zlosynth/kaseta/hack/release.tmpl.md

## Changes

${CHANGES}

## Firmware

Kaseta's firmware can be upgraded to obtain new features and bug-fixes. To do so, download the binary from attachments bellow, navigate to [Electro-Smith's web programmer](https://flash.daisy.audio/) and follow the guide to upload the binary through the "File Upload" tab.
