zlosynth/kaseta/(threads)

Thread 2 (2023-10-07):

Hardware final?

KeLaiFu, 2023-10-07:
I'm considering getting a few daisy boards and found your 2 projects, which both look great. Could you confirm if the hardware is finalized (for kaseta and achordian) before I throw my money at thonk?

Awesome looking modules and thanks for sharing them 👍👍👍

phoracek, 2023-10-07:
Hey! I'm happy you like my modules. I consider hardware of both of them done. I don't plan any changes to their schema or layout at the moment. If there ever would be any modifications to them, they would be backwards compatible.

KeLaiFu, 2023-10-09:
thanks for the reply, that's great news. I will get the iron warmed up!

Closed 2023-10-09.
