zlosynth/kaseta/(commit log)

2022-08-07 Fix import in oversampling doctest
    [mod.rs]
2022-08-12 Reduce oversampling to 4x
    With the current (lack of) optimization, my laptop cannot keep up with
    8x oversampling.
    This patch reduces oversampling in expense of aliasing.
2022-08-22 Fix the direction of delay
    [mod.rs]
2022-09-11 Adapt wow to inverted buffers
    [mod.rs]
2022-09-11 Switch upsampling to kaseta buffer
2022-09-11 Switch downsampling to kaseta buffer
2022-09-11 Fix ring buffer peeking
    [mod.rs]
2022-09-12 Fix linter after oversampling optimization
    [mod.rs]
2022-09-12 Remove signal binding from oversampling
    [mod.rs]
2022-10-01 Keep Wow attributes in its own struct
    Avoid accessing attributes of nested primitives.
    [mod.rs]
2022-10-01 Expose wow amplitude spring
2022-10-01 Cover wow module with prop tests
2022-10-01 Use a custom state variable filter
2022-10-01 Control filtering of wow amplitude
2022-10-01 Generalize wow filter for the whole wave
2022-10-01 Assure that filter does not put wow beyond limits
2022-10-03 Document danger zone switch
2022-10-04 Initialize kicad project
    [Module.kicad_pcb, Module.kicad_sch]
2022-10-04 Design basic interface panel outline
    [Module.kicad_pcb, Module.kicad_sch]
2022-10-14 Remove dedicated head switches from control
2022-10-15 Allow switching of delay range
2022-10-15 Rearange jacks on the PCB
    This way it should fit Daisy.
    [Module.kicad_pcb, Module.kicad_sch]
2022-10-17 Implement basic rewind feature
    Scrolling to the past acts as 1 octave down pitch shift.
2022-10-28 Add impulse LED to the PCB
    [Module.kicad_pcb, Module.kicad_sch]
2022-10-28 Align jacks, delay and big pots
    [Module.kicad_pcb, Module.kicad_sch]
2022-10-28 Place pot labels and fix their order
    [Module.kicad_pcb]
2022-10-28 Align sliders and rest of the pots
    [Module.kicad_pcb]
2022-10-28 Align LEDs on PCB and add labels
    [Module.kicad_pcb]
2022-10-28 Show Daisy labels on the correct side of board
    [Module.kicad_pcb]
2022-10-29 Align button and its LED
    [Module.kicad_pcb]
2022-10-29 All labels to peripherals
    [Module.kicad_pcb, Module.kicad_sch]
2022-10-29 Position DIP switch socket
    [Module.kicad_pcb]
2022-10-29 Add labels to peripherals in schematic
    [Module.kicad_sch]
2022-10-29 Set PCB and schematic title
    [Module.kicad_pcb, Module.kicad_sch]
2022-10-30 Add release script
    [Module.kicad_pcb]
2022-10-30 Release version 0.1.0
    [Module.kicad_pcb, Module.kicad_sch]
2022-10-30 Release version 0.2.0
    [Module.kicad_pcb, Module.kicad_sch]
2022-11-06 Control wow using a single attribute
    With this patch, most of the wow input attributes were replaced by hardcoded
    values. The only attribute that can be controlled is wow's depth.
    [mod.rs]
2022-11-06 Release versoin 0.3.0
    [Module.kicad_pcb, Module.kicad_sch]
2022-11-07 Align bottom-most pot with the a jack in Achordion
    [Module.kicad_pcb]
2022-11-07 Align PCB with panel design
    [Module.kicad_pcb]
2022-11-07 Add I2C connection to the schematic
    [Module.kicad_pcb, Module.kicad_sch]
2022-11-07 Add power to the schematic
    [Module.kicad_pcb, Module.kicad_sch]
2022-11-07 Add LEDs to the schematic
    [Module.kicad_pcb, Module.kicad_sch]
2022-11-07 Add power to the MCU in schematics
    [Module.kicad_sch]
2022-11-07 Connect jacks in the schematics
    [Module.kicad_pcb, Module.kicad_sch]
2022-11-07 Add pots to the schematic
    [Module.kicad_sch]
2022-11-07 Add multiplexers into the schematic
    [Module.kicad_pcb, Module.kicad_sch]
2022-11-07 Use pull-down resistors for muxed DIP
    [Module.kicad_sch]
2022-11-07 Temporary mapping of I/O in schematics
    [Module.kicad_pcb, Module.kicad_sch]
2022-11-08 Add holes under jack sockets in PCB
    [Module.kicad_pcb]
2022-11-08 Rely on the on-board power filters and protection
    Daisy patch SM has backward power protection installed and all
    the other components on board are using only power provided from Daisy.
    [Module.kicad_pcb, Module.kicad_sch]
2022-11-08 Wire up the bottom half of the PCB
    [Module.kicad_pcb, Module.kicad_sch]
2022-11-08 Wire up everything except for LEDs
    [Module.kicad_pcb, Module.kicad_sch]
2022-11-09 Wire up the rest of the board
    And also add some silk screen goodies.
    [Module.kicad_pcb, Module.kicad_sch]
2022-11-09 Select JLCPCB parts for BOM
    [Module.kicad_pcb]
2022-11-09 Add a note about JLC PCB tools
2022-11-09 Fix power on DIP switch
    It should be 3.3 V, otherwise it would burn Daisy.
    [Module.kicad_pcb, Module.kicad_sch]
2022-11-09 Prepare for gerber generating
    [Module.kicad_pcb, Module.kicad_sch]
2022-11-12 Install rust arm toolchain
2022-11-12 Blink status LED
2022-11-12 Introduce board abstraction with GPIO bindings
    [button.rs, debounced.rs, mod.rs, multiplexer.rs]
2022-11-12 Bind CV peripherals to the board abstraction
2022-11-12 Implement binding for pot peripherals
    [button.rs, mod.rs, pots.rs]
2022-11-13 Implement input probe
    Probes will detect whether there is anything connected to CV inputs.
2022-11-13 Fix wrongly positioned daisy footprint
    [Module.kicad_pcb, Module.kicad_sch]
2022-11-14 Remap firmware pins based on the PCB rework
    [button.rs, cvs.rs, multiplexer.rs, pots.rs]
2022-11-14 Implement LEDs access interface
2022-11-17 Implement calibration calculator
2022-11-17 Implement calibration state machine
2022-11-18 Utilize calibration on control inputs
2022-11-18 Implement impulse led output
2022-11-18 Test led and trigger impulse outputs
2022-11-26 Adjust trimmer footprints
    Holder leg holes in the regular ones are too small to fit.
    [Module.kicad_pcb, Module.kicad_sch]
2022-11-26 Rotate trim pots upright
    [Module.kicad_pcb, Module.kicad_sch]
2022-11-26 Get rid of unnecessary vias
    [Module.kicad_pcb]
2022-11-26 Accomodate for thick legs of preci DIP
    [Module.kicad_pcb, Module.kicad_sch]
2022-11-26 Revert "Accomodate for thick legs of preci DIP"
    This reverts commit 377adedf2e79c55a6d2cbc0ca7191f653849c237.
    [Module.kicad_pcb, Module.kicad_sch]
2022-11-26 Validate correctness of the PCB
    [Module.kicad_pcb]
2022-11-27 Move control button to its own module
2022-11-27 Move switch to its own module
2022-11-27 Move calibration to its own module
2022-11-28 Release version 0.4.0
    [Module.kicad_pcb, Module.kicad_sch]
2022-11-29 Fix PCB project file broken by release
    [Module.kicad_pcb]
2022-11-29 Remove outdated control flow diagram
2022-11-30 Move calibration default to module
2022-12-02 Share button helpers in store tests
2022-12-02 Address linter issues from latest Rust
    [mod.rs]
2022-12-04 Keep kaseta label on PCB in copper
    [Module.kicad_pcb]
2022-12-04 Resolve new linter complaints
    [mod.rs]
2022-12-04 Implement firmware binding for audio
    [audio.rs, mod.rs, randomizer.rs]
2022-12-10 Apply DC blocking filter on output
2022-12-11 Release version 0.5.0
    [Module.kicad_pcb, Module.kicad_sch]
2022-12-13 Fix number of mux cycles
    [mod.rs]
2022-12-13 Fix transposition of pots adc
    [pots.rs]
2022-12-13 Fix mapping of pots in mux
    [pots.rs]
2022-12-13 Workaround invalid pin mapping on Daisy
    [mod.rs, probe.rs]
2022-12-13 Add LED embedded test
2022-12-13 Fix buttons unfiltered active method
    [button.rs]
2022-12-19 Fix order of switches in firmware
2022-12-19 Remove unnecessary cast of sample rate
2022-12-19 Fix control mapping detection
    [store.rs]
2022-12-19 Use raw control input to prevent glide
    [store.rs]
2022-12-19 Pin to daisy lib with fixed ADC
2022-12-21 Fix configuration mode tests
    [store.rs]
2022-12-21 Control pre-amp mode using alt button
2022-12-24 Sustain alt menu while button is held
2022-12-28 Control tone filter position using alt button
2023-01-02 Resolve clippy issues in control
    [mod.rs, store.rs]
2023-01-02 Fix tempo save test
    [store.rs]
2023-01-02 Fix speed config after tap restoration
    [store.rs]
2023-01-02 Release version 0.6.0
    [Module.kicad_pcb, Module.kicad_sch]
2023-01-02 Fix logging of loaded save version
    [storage.rs]
2023-01-03 Replace processor speed constant with function
    [mod.rs]
2023-01-03 Optimize probe handling using wrap around
2023-01-06 Shorten impulse led blinks
2023-01-07 Fix range of pre-amp leds
2023-01-07 Activate alt attribute led by movement
2023-01-08 Follow 1v/oct scaling with tone
2023-01-08 Use Linkwirz-Riley filter for tone
    With this filter, it can withstand high frequencies and can be used in
    a way it does not pop while transitioning from lowpass to highpass.
2023-01-17 Remove relative ordering of head display
    When all heads are on the side, or some are disabled, it can get just
    more confusing. Fixing it would be difficult and I'm not sure if it
    would be worth it. Also, I feel lazy lately.
    With this change, the heads display order is fixed, left->right,
    top->bottom.
    [store.rs]
2023-01-18 Filter out noise from position/speed pots
2023-01-19 Use DC blocker before delay
    This blocks a DC offset caused by hysteresis. Removing this small
    offset avoids some of the boot click amplified by feedback.
    [mod.rs]
2023-01-20 Fix tests with new pot smoothening
    [store.rs]
2023-01-21 Release version 0.7.0
    [Module.kicad_pcb, Module.kicad_sch]
2023-01-21 Remove DIP switch from the PCB
    [Module.kicad_pcb, Module.kicad_sch]
2023-01-21 Cleanup DIP switch related code
2023-01-21 Update JLCPCB plugin to 2023.01.02
    [Module.kicad_pcb]
2023-01-21 Reflect current features in user manual
2023-01-22 Document signal flow in user guide
2023-01-22 Document mapping and calibration
2023-02-12 Reword LED cathode hint
    [Module.kicad_pcb]
2023-02-12 Mark standoff on silkscreen
    [Module.kicad_pcb]
2023-02-16 Complete the text of the build manual
    [Module.kicad_pcb]
2023-03-05 Enlarge snap-in holes for trim pots
    [Module.kicad_pcb]
2023-03-05 Rename Switch on PCB to Button
    Keep it consistent with the build and user manual.
    [Module.kicad_pcb]
2023-03-20 Release version 1.0.0
    [Module.kicad_pcb, Module.kicad_sch]
2023-03-22 Keep JLCPCB BOM mapping in the schematic
    Without this, sync of the PCB from the schematic always resets the
    mapping.
    [Module.kicad_pcb, Module.kicad_sch]
2023-03-22 Clearly mark the power connector on the PCB
    [Module.kicad_pcb]
2023-04-21 Fix pedantic clippy checks
    [store.rs]
2023-07-05 Change the maximum value of medium speed to 8s
    With this, the length of the delay matches how many LEDs are lit.
2023-07-05 Support clock inputs resting in negative voltage
2023-07-05 Release version 1.1.0
    [Module.kicad_pcb, Module.kicad_sch]
2023-07-10 Document real current consumption
2023-07-10 Clarify what happens after calibration
2023-07-12 Release version 1.1.1
    [Module.kicad_pcb, Module.kicad_sch]
2023-07-17 Release version 1.1.2
    [Module.kicad_pcb, Module.kicad_sch]
2023-08-07 Swap wow/flut and tone processors
    This change prepares wow/flut processor to be eventually shiftable
    between the write and read position.
    [mod.rs]
2023-08-08 Make position of wow/flut internally switchable
2023-08-13 Enter configuration menu only after a minute
    This is to make space for the buffer reset functionality.
    [store.rs]
2023-08-13 Fix unit tests after changes to config menu
    [store.rs]
2023-08-13 Clear the entire tape by holding the button for 3 seconds
2023-08-13 Update docs changelog and LED blink
2023-08-13 Fix new clippy complaint
    [store.rs]
2023-08-19 Set the shortest save interval to 1 second
    With this change, save requests are accumulated over 1 second before
    storing.
    This makes sure that even under lot of load and rapid changes of
    storable options, the CPU won't be overwhelmed by saving.
    This is addressing an issue where mapping CV input to SPEED while
    the current tempo is tapped in would produce 2 saves one after the
    other, stressing the module and lowering the idle time momentarily
    below 7 percent.
2023-08-20 Bump kicad project version
    [Module.kicad_pcb, Module.kicad_sch]
2023-08-20 Add pot values to schematic
    [Module.kicad_sch]
2023-08-26 Release version 1.2.0
    [Module.kicad_pcb, Module.kicad_sch]
2023-09-30 Add WEEE and CE logos
    [Module.kicad_pcb]
2023-10-09 Remove CE and WEEE again
    Don't use these on open hardware with my name on the board unless I can
    attest that given build is compatible.
    [Module.kicad_pcb]
2023-10-23 Allow customization of the default screen
    LED can be now configured to visualize the current position within the
    loop. This is useful especially when using the module as a looper.
2023-10-28 Allow reset of loop position through CV
    [mod.rs, store.rs]
2023-10-28 Revert "Never go back when showing the position"
    This reverts commit e9d5b360eeb4514d16f3c2b30a3b77ae65c9bf59.
    Depsite it is slightly better visually, it is not as good in getting
    a grasp on where we are in the loop.
    [mod.rs]
2023-11-11 Fix buffer reset visualization
    [mod.rs]
2023-11-11 Make buffer reset 2x faster
    [mod.rs]
2023-11-12 Fix clamping of CV
    [cvs.rs]
2023-11-12 Fix bug where position display was not default
    [store.rs]
2023-11-14 Prevent pops after unpause
    Sudden jump to far-from-zero amplitude on input during unpause is fed
    into the feedback which then repeats the pop indefinitely.
    With this patch, input audio is faded-in/out after/before unpause.
    [mod.rs]
2023-11-14 Prevent wobble noises produced by short feedback
    [mod.rs]
2023-11-17 Release version 1.3.0
    [Module.kicad_pcb, Module.kicad_sch]
2023-12-03 Release version 1.3.1
    [Module.kicad_pcb, Module.kicad_sch]
2024-02-19 Release version 1.3.2
    [Module.kicad_pcb, Module.kicad_sch]
2024-09-07 Pin to Rust 1.76.0
    Newer versions bloat the firmware.
2024-09-07 Pin to Rust 1.77.0
    This is needed to be able to build some of the dependencies.
2024-10-20 Pin LLVM Rust version
2024-12-22 Document new kits with screw washer
2024-12-23 Add successful flash led
2025-10-11 Add an additional power filtering and protection
    It should be already handled by the Patch SM, but better safe than
    sorry.
    [Module.kicad_pcb, Module.kicad_sch]
2025-10-11 Commit all lock files
    To make sure that the depedencies won't increase their minimal supported
    rust version and break the build, commit all the lock files.
    [debounced.rs]
2025-10-11 Release version 1.3.3
    [Module.kicad_pcb, Module.kicad_sch]
2025-10-11 Fix the PCB board version bump script
    [Module.kicad_pcb]
2025-10-11 Use bininstal for CI
    This is much faster than building the tools. With this change we also
    pin to a specific versions of these tools for reproducible builds.
2026-03-06 Move impulse farther from input
    [Module.kicad_pcb]
2026-07-17 Update project to KiCad 10
    [Module.kicad_pcb, Module.kicad_sch]
2026-07-17 Switch to library ferrites
    [Module.kicad_sch]
2026-07-17 Switch to alpha sliders
    [Module.kicad_pcb]
2026-07-17 Clarify GND net fill zone
    [Module.kicad_pcb, Module.kicad_sch]
2026-07-17 Thin the tracks to widen the spacing
    [Module.kicad_pcb]
2026-07-17 Ignore KiCad 10 history files
2026-07-17 Use better footprints
    [Module.kicad_pcb, Module.kicad_sch]
2026-07-17 Adapt manual and silkscreen to new pots
    Alpha is not blue.
    [Module.kicad_pcb]
2026-07-17 Simplify connector soldering procedure
    New better footprints allow this.
2026-07-17 Pin taplo to unblock builds
2026-07-17 Release version 1.3.4
    [Module.kicad_pcb, Module.kicad_sch]
2026-08-15 Fix the Alpha slider footprint orientation
