zlosynth/kaseta/(notices)

Notices in the files:
hardware/Module.kicad_sch:
CC BY-SA
hardware/Module.kicad_pcb:
2023, CC BY-SA
